Telly-S/Multiphase-Buck-Boost-Power-Supply/poster.png

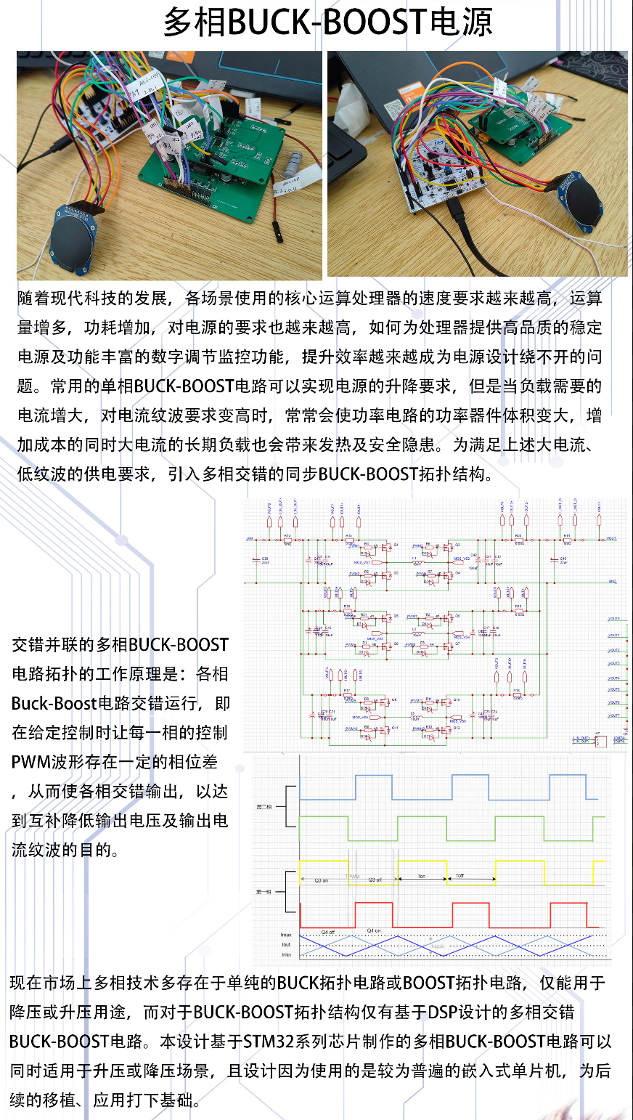
poster.png
