Telly-S/Multiphase-Buck-Boost-Power-Supply/README.md

2023 ST-嵌入式大赛 多相Buck-Boost电源
---

## 简介
本作品设计以 STM32G474 为主控芯片，本作品设计输出电源的范围为 0~30V 可调，在外接直流电源提供基础供能下，可以把任意范围内的输入电压转化为想要的输出电压，且由于电路的整流作用和闭环设计，使得输出的电源稳定、整洁。[介绍视频](https://www.alipan.com/s/BqMXYns31si)

## 介绍海报：
(https://postimg.cc/QVMbn3c7)

详细内容参见所附论文《多相Buck-Boost电源》

## 技术要点

| 功能 | 实现 | 说明 |
|:---|:---|:-----|
| 升降压 | 基于HRTIM的PWM | 信号成对出现，波形互补。信号切换时需要有死区的保护。 |
| 电流电压反馈 | adc | 多路adc监测输入输出时各通道的电流电压情况|
| 电压电流调节 | pid调控 | 主循环周期性调控 |
| 目标电压设定 | usart | 串口中断接收上位机指令 |
| 屏幕显示 | spi+lvgl | 定期刷新屏幕数据 |
