Telly-S/Multiphase-Buck-Boost-Power-Supply/Core/Src/main.c

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
/* Includes ------------------------------------------------------------------*/
#include "main.h"
#include "adc.h"
#include "hrtim.h"
#include "usart.h"
#include "spi.h"
#include "tim.h"
#include "gpio.h"

/* USER CODE BEGIN Includes */
#include "buck-boost.h"
#include "usmart.h"
#include "display.h"
#include "display_test.h"
#include "lvgl.h"
#include "display_conf.h"
#include "lv_port_disp_template.h"
#include "showAD.h"
/* USER CODE END Includes */


/* USER CODE BEGIN PV */
float ADval;
//float overall_out_u_fact, overall_in_u;  // 总输入输出电压(ADC实测值)
//float overall_out_u_target;  // 目标输出电压
RunMode_t runMode = noMode;
/* USER CODE END PV */

void SystemClock_Config(void);
/* USER CODE BEGIN 0 */
void changeModeFunc(void)
{
  if(v_out_target + delta_v < v_in)
  {
    //printf("enter buck \r\n");
    // 同步Buck模式
    switch(runMode)
    {
      case noMode:break;
      case SynchronizeBuckMode: /*synchronization_buck_mode(exitMode);*/ break;
      case IncreaseBuckboostMode: increase_buckboost_mode(exitMode); break;
      case DecreaseBuckboostMode: decrease_buckboost_mode(exitMode); break;
      case SynchronizeBoostMode: synchronization_boost_mode(exitMode); break;
    }

    if(runMode != SynchronizeBuckMode)
      synchronization_buck_mode(enterMode);

    runMode = SynchronizeBuckMode;
    synchronization_buck_mode(executeMode);
  }
  else if(v_out_target <= v_in && v_in <= v_out_target + delta_v)
  {
    //printf("enter reduce buck-boost\r\n");
    // 降压Buck Boost模式
    switch(runMode)
    {
      case noMode:break;
      case SynchronizeBuckMode: synchronization_buck_mode(exitMode); break;
      case IncreaseBuckboostMode: increase_buckboost_mode(exitMode); break;
      case DecreaseBuckboostMode: /*decrease_buckboost_mode(exitMode);*/ break;
      case SynchronizeBoostMode: synchronization_boost_mode(exitMode); break;
    }

    if(runMode != DecreaseBuckboostMode)
      decrease_buckboost_mode(enterMode);

    runMode = DecreaseBuckboostMode;
    decrease_buckboost_mode(executeMode);  // execute mode
  }
  else if(v_in < v_out_target && v_out_target <= v_in + delta_v)
  {
    // 升压Buck Boost模式
    //printf("enter incrase buck-boost\r\n");
    switch(runMode)
    {
      case noMode:break;
      case SynchronizeBuckMode: synchronization_buck_mode(exitMode); break;
      case IncreaseBuckboostMode: /*increase_buckboost_mode(exitMode);*/ break;
      case DecreaseBuckboostMode: decrease_buckboost_mode(exitMode); break;
      case SynchronizeBoostMode: synchronization_boost_mode(exitMode); break;
    }

    if(runMode != IncreaseBuckboostMode)
      increase_buckboost_mode(enterMode);

    runMode = IncreaseBuckboostMode;
    increase_buckboost_mode(executeMode);
  }
  else if(v_in + delta_v < v_out_target)
  {
    // 同步Boost模式
//    printf("enter boost \r\n");
    switch(runMode)
    {
      case noMode:break;
      case SynchronizeBuckMode: synchronization_buck_mode(exitMode); break;
      case IncreaseBuckboostMode: increase_buckboost_mode(exitMode); break;
      case DecreaseBuckboostMode: decrease_buckboost_mode(exitMode); break;
      case SynchronizeBoostMode: /*synchronization_boost_mode(exitMode);*/ break;
    }

    if(runMode != SynchronizeBoostMode)
      synchronization_boost_mode(enterMode);

    runMode = SynchronizeBoostMode;
    synchronization_boost_mode(executeMode);
  }
}
/* USER CODE END 0 */

/**
  * @brief  The application entry point.
  * @retval int
  */
int main(void)
{
  /* MCU Configuration--------------------------------------------------------*/

  /* Reset of all peripherals, Initializes the Flash interface and the Systick. */
  HAL_Init();

  /* Configure the system clock */
  SystemClock_Config();

  /* Initialize all configured peripherals */
  MX_GPIO_Init();
  MX_ADC1_Init();
  MX_ADC2_Init();
  MX_HRTIM1_Init();
  MX_LPUART1_UART_Init();
  MX_SPI3_Init();
  MX_TIM3_Init();
  /* USER CODE BEGIN 2 */
  HAL_TIM_Base_Start_IT(&htim3);
  lv_init();
	lv_port_disp_init();
	AD_label_event_init();
  
  HAL_HRTIM_WaveformOutputStart(&hhrtim1, HRTIM_TIMERID_MASTER);  // 开启主时钟同步
  HAL_HRTIM_WaveformCountStart(&hhrtim1, HRTIM_TIMERID_MASTER);
  
  // HAL_HRTIM_WaveformOutputStart(&hhrtim1, HRTIM_OUTPUT_TA1 | HRTIM_OUTPUT_TA2);
  // HAL_HRTIM_WaveformCountStart(&hhrtim1, HRTIM_TIMERID_TIMER_A);
  // HAL_HRTIM_WaveformOutputStart(&hhrtim1, HRTIM_OUTPUT_TB1 | HRTIM_OUTPUT_TB2);
  // HAL_HRTIM_WaveformCountStart(&hhrtim1, HRTIM_TIMERID_TIMER_B);
  HAL_HRTIM_WaveformOutputStart(&hhrtim1, HRTIM_OUTPUT_TC1 | HRTIM_OUTPUT_TC2);
  HAL_HRTIM_WaveformCountStart(&hhrtim1, HRTIM_TIMERID_TIMER_C);
  HAL_HRTIM_WaveformOutputStart(&hhrtim1, HRTIM_OUTPUT_TD1 | HRTIM_OUTPUT_TD2);
  HAL_HRTIM_WaveformCountStart(&hhrtim1, HRTIM_TIMERID_TIMER_D);
  HAL_HRTIM_WaveformOutputStart(&hhrtim1, HRTIM_OUTPUT_TE1 | HRTIM_OUTPUT_TE2);
  HAL_HRTIM_WaveformCountStart(&hhrtim1, HRTIM_TIMERID_TIMER_E);
  HAL_HRTIM_WaveformOutputStart(&hhrtim1, HRTIM_OUTPUT_TF1 | HRTIM_OUTPUT_TF2);
  HAL_HRTIM_WaveformCountStart(&hhrtim1, HRTIM_TIMERID_TIMER_F);
  /* USER CODE END 2 */

  /* Infinite loop */
  /* USER CODE BEGIN WHILE */
  // __HAL_HRTIM_SETCOMPARE(&hhrtim1, 0x0, HRTIM_COMPAREUNIT_1, 0);  // 0x0 to 0x5 for timers A to F
  // __HAL_HRTIM_SETCOMPARE(&hhrtim1, 0x1, HRTIM_COMPAREUNIT_1, 0);  // PWM set zero
  __HAL_HRTIM_SETCOMPARE(&hhrtim1, 0x2, HRTIM_COMPAREUNIT_1, 0);
  __HAL_HRTIM_SETCOMPARE(&hhrtim1, 0x3, HRTIM_COMPAREUNIT_1, 0);
  __HAL_HRTIM_SETCOMPARE(&hhrtim1, 0x4, HRTIM_COMPAREUNIT_1, 0);
  __HAL_HRTIM_SETCOMPARE(&hhrtim1, 0x5, HRTIM_COMPAREUNIT_1, 0);
  
  usmart_dev.init(0);		//初始化USMART
  config_param_init();  // 预设参数初始化
  v_out_target = 1.8;  // 这个考虑定时器中断进行修改
  while (1)
  {
    change_AD_data(0, 11.0);
    // v_in 是否需要做成动态采集    
    v_in = Get_Adc_MidValue(overall_in.adcx_ptr, overall_in.ADC_Channel);
    printf("v_in: %f\r\n", v_in);
    
    if(v_in > 0.9f)  // 必须要有一定的输入电压
      changeModeFunc();
    else
      printf("v_in is too low to run\r\n");
    
    HAL_Delay(120);  // TODO 时间暂时调大，便于调试

    HAL_GPIO_TogglePin(LD2_GPIO_Port, LD2_Pin);
    
    usmart_dev.scan(); // 执行usmart扫描
    lv_timer_handler();
    
    printf("draw: %f,%f,%f\r\n", v_out_target, Get_Adc_MidValue(overall_out.adcx_ptr, overall_out.ADC_Channel),
                                    Get_Adc_MidValue(overall_in.adcx_ptr, overall_in.ADC_Channel)
                                    );
    /* USER CODE END WHILE */

    /* USER CODE BEGIN 3 */
  }
  /* USER CODE END 3 */
}

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
