Telly-S/Multiphase-Buck-Boost-Power-Supply/Core/Inc/main.h

#define B1_Pin GPIO_PIN_13
#define B1_GPIO_Port GPIOC
#define LPUART1_TX_Pin GPIO_PIN_2
#define LPUART1_TX_GPIO_Port GPIOA
#define LPUART1_RX_Pin GPIO_PIN_3
#define LPUART1_RX_GPIO_Port GPIOA
#define LD2_Pin GPIO_PIN_5
#define LD2_GPIO_Port GPIOA
#define T_SWDIO_Pin GPIO_PIN_13
#define T_SWDIO_GPIO_Port GPIOA
#define T_SWCLK_Pin GPIO_PIN_14
#define T_SWCLK_GPIO_Port GPIOA
#define T_SWO_Pin GPIO_PIN_3
#define T_SWO_GPIO_Port GPIOB
#define SCLK_Pin		GPIO_PIN_10
#define SCLK_GPIO_Port	GPIOC
#define MOSI_Pin 		GPIO_PIN_12
#define MOSI_GPIO_Port 	GPIOC
#define DC_Pin 		GPIO_PIN_7
#define DC_GPIO_Port	GPIOB
#define RES_Pin GPIO_PIN_6
#define RES_GPIO_Port GPIOB
#define CS_Pin GPIO_PIN_5
#define CS_GPIO_Port GPIOB
