Telly-S/Multiphase-Buck-Boost-Power-Supply/Core/Src/adc.c

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
/* Includes ------------------------------------------------------------------*/
#include "adc.h"

/* USER CODE BEGIN 0 */
#include <stdio.h>
/* USER CODE END 0 */

ADC_HandleTypeDef hadc1;
ADC_HandleTypeDef hadc2;

/* ADC1 init function */
void MX_ADC1_Init(void)
{

  ADC_MultiModeTypeDef multimode = {0};
  ADC_ChannelConfTypeDef sConfig = {0};

  /** Common config
  */
  hadc1.Instance = ADC1;
  hadc1.Init.ClockPrescaler = ADC_CLOCK_SYNC_PCLK_DIV4;
  hadc1.Init.Resolution = ADC_RESOLUTION_12B;
  hadc1.Init.DataAlign = ADC_DATAALIGN_RIGHT;
  hadc1.Init.GainCompensation = 0;
  hadc1.Init.ScanConvMode = ADC_SCAN_DISABLE;
  hadc1.Init.EOCSelection = ADC_EOC_SINGLE_CONV;
  hadc1.Init.LowPowerAutoWait = DISABLE;
  hadc1.Init.ContinuousConvMode = DISABLE;
  hadc1.Init.NbrOfConversion = 1;
  hadc1.Init.DiscontinuousConvMode = DISABLE;
  hadc1.Init.ExternalTrigConv = ADC_SOFTWARE_START;
  hadc1.Init.ExternalTrigConvEdge = ADC_EXTERNALTRIGCONVEDGE_NONE;
  hadc1.Init.DMAContinuousRequests = DISABLE;
  hadc1.Init.Overrun = ADC_OVR_DATA_PRESERVED;
  hadc1.Init.OversamplingMode = DISABLE;
  if (HAL_ADC_Init(&hadc1) != HAL_OK)
  {
    Error_Handler();
  }

  /** Configure the ADC multi-mode
  */
  multimode.Mode = ADC_MODE_INDEPENDENT;
  if (HAL_ADCEx_MultiModeConfigChannel(&hadc1, &multimode) != HAL_OK)
  {
    Error_Handler();
  }

  /** Configure Regular Channel
  */
  sConfig.Channel = ADC_CHANNEL_1;
  sConfig.Rank = ADC_REGULAR_RANK_1;
  sConfig.SamplingTime = ADC_SAMPLETIME_640CYCLES_5;
  sConfig.SingleDiff = ADC_SINGLE_ENDED;
  sConfig.OffsetNumber = ADC_OFFSET_NONE;
  sConfig.Offset = 0;
  if (HAL_ADC_ConfigChannel(&hadc1, &sConfig) != HAL_OK)
  {
    Error_Handler();
  }
}
/* ADC2 init function */
void MX_ADC2_Init(void)
{

  ADC_ChannelConfTypeDef sConfig = {0};

  /** Common config
  */
  hadc2.Instance = ADC2;
  hadc2.Init.ClockPrescaler = ADC_CLOCK_SYNC_PCLK_DIV4;
  hadc2.Init.Resolution = ADC_RESOLUTION_12B;
  hadc2.Init.DataAlign = ADC_DATAALIGN_RIGHT;
  hadc2.Init.GainCompensation = 0;
  hadc2.Init.ScanConvMode = ADC_SCAN_DISABLE;
  hadc2.Init.EOCSelection = ADC_EOC_SINGLE_CONV;
  hadc2.Init.LowPowerAutoWait = DISABLE;
  hadc2.Init.ContinuousConvMode = DISABLE;
  hadc2.Init.NbrOfConversion = 1;
  hadc2.Init.DiscontinuousConvMode = DISABLE;
  hadc2.Init.ExternalTrigConv = ADC_SOFTWARE_START;
  hadc2.Init.ExternalTrigConvEdge = ADC_EXTERNALTRIGCONVEDGE_NONE;
  hadc2.Init.DMAContinuousRequests = DISABLE;
  hadc2.Init.Overrun = ADC_OVR_DATA_PRESERVED;
  hadc2.Init.OversamplingMode = DISABLE;
  if (HAL_ADC_Init(&hadc2) != HAL_OK)
  {
    Error_Handler();
  }

  /** Configure Regular Channel
  */
  sConfig.Channel = ADC_CHANNEL_3;
  sConfig.Rank = ADC_REGULAR_RANK_1;
  sConfig.SamplingTime = ADC_SAMPLETIME_640CYCLES_5;
  sConfig.SingleDiff = ADC_SINGLE_ENDED;
  sConfig.OffsetNumber = ADC_OFFSET_NONE;
  sConfig.Offset = 0;
  if (HAL_ADC_ConfigChannel(&hadc2, &sConfig) != HAL_OK)
  {
    Error_Handler();
  }
}

static uint32_t HAL_RCC_ADC12_CLK_ENABLED=0;

void HAL_ADC_MspInit(ADC_HandleTypeDef* adcHandle)
{

  GPIO_InitTypeDef GPIO_InitStruct = {0};
  RCC_PeriphCLKInitTypeDef PeriphClkInit = {0};
  if(adcHandle->Instance==ADC1)
  {
  /** Initializes the peripherals clocks
  */
    PeriphClkInit.PeriphClockSelection = RCC_PERIPHCLK_ADC12;
    PeriphClkInit.Adc12ClockSelection = RCC_ADC12CLKSOURCE_SYSCLK;
    if (HAL_RCCEx_PeriphCLKConfig(&PeriphClkInit) != HAL_OK)
    {
      Error_Handler();
    }

    /* ADC1 clock enable */
    HAL_RCC_ADC12_CLK_ENABLED++;
    if(HAL_RCC_ADC12_CLK_ENABLED==1){
      __HAL_RCC_ADC12_CLK_ENABLE();
    }

    __HAL_RCC_GPIOC_CLK_ENABLE();
    __HAL_RCC_GPIOA_CLK_ENABLE();
    __HAL_RCC_GPIOB_CLK_ENABLE();
    /**ADC1 GPIO Configuration
    PC0     ------> ADC1_IN6
    PC1     ------> ADC1_IN7
    PC2     ------> ADC1_IN8
    PC3     ------> ADC1_IN9
    PA0     ------> ADC1_IN1
    PA1     ------> ADC1_IN2
    PB1     ------> ADC1_IN12
    PB11     ------> ADC1_IN14
    */
    GPIO_InitStruct.Pin = GPIO_PIN_0|GPIO_PIN_1|GPIO_PIN_2|GPIO_PIN_3;
    GPIO_InitStruct.Mode = GPIO_MODE_ANALOG;
    GPIO_InitStruct.Pull = GPIO_NOPULL;
    HAL_GPIO_Init(GPIOC, &GPIO_InitStruct);

    GPIO_InitStruct.Pin = GPIO_PIN_0|GPIO_PIN_1;
    GPIO_InitStruct.Mode = GPIO_MODE_ANALOG;
    GPIO_InitStruct.Pull = GPIO_NOPULL;
    HAL_GPIO_Init(GPIOA, &GPIO_InitStruct);

    GPIO_InitStruct.Pin = GPIO_PIN_1|GPIO_PIN_11;
    GPIO_InitStruct.Mode = GPIO_MODE_ANALOG;
    GPIO_InitStruct.Pull = GPIO_NOPULL;
    HAL_GPIO_Init(GPIOB, &GPIO_InitStruct);

  }
  else if(adcHandle->Instance==ADC2)
  {
  /** Initializes the peripherals clocks
  */
    PeriphClkInit.PeriphClockSelection = RCC_PERIPHCLK_ADC12;
    PeriphClkInit.Adc12ClockSelection = RCC_ADC12CLKSOURCE_SYSCLK;
    if (HAL_RCCEx_PeriphCLKConfig(&PeriphClkInit) != HAL_OK)
    {
      Error_Handler();
    }

    /* ADC2 clock enable */
    HAL_RCC_ADC12_CLK_ENABLED++;
    if(HAL_RCC_ADC12_CLK_ENABLED==1){
      __HAL_RCC_ADC12_CLK_ENABLE();
    }

    __HAL_RCC_GPIOA_CLK_ENABLE();
    __HAL_RCC_GPIOC_CLK_ENABLE();
    __HAL_RCC_GPIOB_CLK_ENABLE();
    /**ADC2 GPIO Configuration
    PA4     ------> ADC2_IN17
    PA6     ------> ADC2_IN3
    PA7     ------> ADC2_IN4
    PC4     ------> ADC2_IN5
    PC5     ------> ADC2_IN11
    PB2     ------> ADC2_IN12
    */
    GPIO_InitStruct.Pin = GPIO_PIN_4|GPIO_PIN_6|GPIO_PIN_7;
    GPIO_InitStruct.Mode = GPIO_MODE_ANALOG;
    GPIO_InitStruct.Pull = GPIO_NOPULL;
    HAL_GPIO_Init(GPIOA, &GPIO_InitStruct);

    GPIO_InitStruct.Pin = GPIO_PIN_4|GPIO_PIN_5;
    GPIO_InitStruct.Mode = GPIO_MODE_ANALOG;
    GPIO_InitStruct.Pull = GPIO_NOPULL;
    HAL_GPIO_Init(GPIOC, &GPIO_InitStruct);

    GPIO_InitStruct.Pin = GPIO_PIN_2;
    GPIO_InitStruct.Mode = GPIO_MODE_ANALOG;
    GPIO_InitStruct.Pull = GPIO_NOPULL;
    HAL_GPIO_Init(GPIOB, &GPIO_InitStruct);

  }
}

void HAL_ADC_MspDeInit(ADC_HandleTypeDef* adcHandle)
{

  if(adcHandle->Instance==ADC1)
  {
    /* Peripheral clock disable */
    HAL_RCC_ADC12_CLK_ENABLED--;
    if(HAL_RCC_ADC12_CLK_ENABLED==0){
      __HAL_RCC_ADC12_CLK_DISABLE();
    }

    /**ADC1 GPIO Configuration
    PC0     ------> ADC1_IN6
    PC1     ------> ADC1_IN7
    PC2     ------> ADC1_IN8
    PC3     ------> ADC1_IN9
    PA0     ------> ADC1_IN1
    PA1     ------> ADC1_IN2
    PB1     ------> ADC1_IN12
    PB11     ------> ADC1_IN14
    */
    HAL_GPIO_DeInit(GPIOC, GPIO_PIN_0|GPIO_PIN_1|GPIO_PIN_2|GPIO_PIN_3);

    HAL_GPIO_DeInit(GPIOA, GPIO_PIN_0|GPIO_PIN_1);

    HAL_GPIO_DeInit(GPIOB, GPIO_PIN_1|GPIO_PIN_11);

  }
  else if(adcHandle->Instance==ADC2)
  {
    /* Peripheral clock disable */
    HAL_RCC_ADC12_CLK_ENABLED--;
    if(HAL_RCC_ADC12_CLK_ENABLED==0){
      __HAL_RCC_ADC12_CLK_DISABLE();
    }

    /**ADC2 GPIO Configuration
    PA4     ------> ADC2_IN17
    PA6     ------> ADC2_IN3
    PA7     ------> ADC2_IN4
    PC4     ------> ADC2_IN5
    PC5     ------> ADC2_IN11
    PB2     ------> ADC2_IN12
    */
    HAL_GPIO_DeInit(GPIOA, GPIO_PIN_4|GPIO_PIN_6|GPIO_PIN_7);

    HAL_GPIO_DeInit(GPIOC, GPIO_PIN_4|GPIO_PIN_5);

    HAL_GPIO_DeInit(GPIOB, GPIO_PIN_2);

  }
}

/* USER CODE BEGIN 1 */

adc_gather  phase1out_u = {&hadc1, ADC_CHANNEL_1}, 
            phase1out_i = {&hadc1, ADC_CHANNEL_2},
            phase2out_u = {&hadc1, ADC_CHANNEL_6}, 
            phase2out_i = {&hadc1, ADC_CHANNEL_7}, 
            phase3out_u = {&hadc1, ADC_CHANNEL_8}, 
            phase3out_i = {&hadc1, ADC_CHANNEL_9},
            phase1in_u  = {&hadc1, ADC_CHANNEL_12},
            phase1in_i  = {&hadc1, ADC_CHANNEL_14},
            phase2in_u  = {&hadc2, ADC_CHANNEL_3},
            phase2in_i  = {&hadc2, ADC_CHANNEL_4},
            phase3in_u  = {&hadc2, ADC_CHANNEL_5},
            phase3in_i  = {&hadc2, ADC_CHANNEL_11},
            overall_out = {&hadc2, ADC_CHANNEL_12},
            overall_in  = {&hadc2, ADC_CHANNEL_17};

//获得 ADC 值
//ch: 通道值 0~16，取值范围为：ADC_CHANNEL_0~ADC_CHANNEL_16
//返回值:转换结果
uint32_t Get_Adc(ADC_HandleTypeDef * hadc_ptr, uint32_t ch)
{
  ADC_ChannelConfTypeDef sConfig = {0};
  sConfig.Channel = ch;
  sConfig.Rank = ADC_REGULAR_RANK_1;
  sConfig.SamplingTime = ADC_SAMPLETIME_640CYCLES_5;
  sConfig.SingleDiff = ADC_SINGLE_ENDED;
  sConfig.OffsetNumber = ADC_OFFSET_NONE;
  sConfig.Offset = 0;
  if (HAL_ADC_ConfigChannel(hadc_ptr, &sConfig) != HAL_OK)
  {
    Error_Handler();
  }
  
  HAL_ADCEx_Calibration_Start(hadc_ptr, ADC_SINGLE_ENDED);
  
  HAL_ADC_Start(hadc_ptr);                      //开启 AD
  HAL_ADC_PollForConversion(hadc_ptr, 10);      //轮询转换
  return (uint32_t)HAL_ADC_GetValue(hadc_ptr);  //返回最近转换结果
}

/**
 * @brief 获取指定通道的电压值
 * 
 * @param hadc_ptr : adcx_ptr
 * @param ch       : 通道
 * @param times    : 均衡次数
 * @return float   : 电压值
 */
float Get_Adc_Average(ADC_HandleTypeDef * hadc_ptr, uint32_t ch, uint8_t times)
{
  uint32_t temp_val=0;
  uint8_t t;
  for(t=0; t<times; t++)
  {
    temp_val += Get_Adc(hadc_ptr, ch);
    HAL_Delay(1);
  }
  return (float)(((temp_val/times)*(3.3/4095))*10.0);
}

/**
 * @brief 获取指定通道的电压值（中值滤波）
 * 
 * @param hadc_ptr : adcx_ptr
 * @param ch       : 通道
 * @return float   : 电压值
 */
float Get_Adc_MidValue(ADC_HandleTypeDef * hadc_ptr, uint32_t ch)
{
  const uint8_t arrayLen = 20;
  float v_in_array[arrayLen] = {0};
  for(uint8_t i = 0; i < arrayLen; i++)
      v_in_array[i] = Get_Adc_Average(hadc_ptr, ch, 1);
  
  float temp = 0.0f;
  for(uint8_t i = 0; i < arrayLen-1; i++)
  {
    for(uint8_t j = 0; j < arrayLen-1-i; j++)
    {
      if(v_in_array[j] > v_in_array[j+1])
      {
        temp = v_in_array[j];
        v_in_array[j] = v_in_array[j+1];
        v_in_array[j+1] = temp;
      }
    }
  }
//  for(uint8_t i = 0; i < arrayLen; i++) 
//      printf("%.2f ", v_in_array[i]);
//    printf("\r\n");
  
  return v_in_array[6];
}

/* USER CODE END 1 */
