Telly-S/Multiphase-Buck-Boost-Power-Supply/Core/Src/usart.c

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
/* Includes ------------------------------------------------------------------*/
#include "usart.h"

/* USER CODE BEGIN 0 */
// 串口1中断服务程序
// 注意,读取USARTx->SR能避免莫名其妙的错误
uint8_t USART_RX_BUF[USART_REC_LEN]; // 接收缓冲,最大USART_REC_LEN个字节.
// 接收状态
// bit15，	接收完成标志
// bit14，	接收到0x0d
// bit13~0，	接收到的有效字节数目
uint16_t USART_RX_STA = 0; // 接收状态标记

uint8_t aRxBuffer[RXBUFFERSIZE]; // HAL库使用的串口接收缓冲

// 接收回调函数
void HAL_UART_RxCpltCallback(UART_HandleTypeDef *huart)
{
  if (huart->Instance == LPUART1) // 如果是P串口1
  {
    if ((USART_RX_STA & 0x8000) == 0) // 接收未完成
    {
      if (USART_RX_STA & 0x4000) // 接收到了0x0d
      {
        if (aRxBuffer[0] != 0x0a)
          USART_RX_STA = 0; // 接收错误,重新开始
        else
          USART_RX_STA |= 0x8000; // 接收完成了
      }
      else // 还没收到0X0D
      {
        if (aRxBuffer[0] == 0x0d)
          USART_RX_STA |= 0x4000;
        else
        {
          USART_RX_BUF[USART_RX_STA & 0X3FFF] = aRxBuffer[0];
          USART_RX_STA++;
          if (USART_RX_STA > (USART_REC_LEN - 1))
            USART_RX_STA = 0; // 接收数据错误,重新开始接收
        }
      }
    }
    HAL_UART_Receive_IT(&hlpuart1, (uint8_t *)aRxBuffer, RXBUFFERSIZE); // 开启下一次接收中断
  }
}
/* USER CODE END 0 */

UART_HandleTypeDef hlpuart1;

/* LPUART1 init function */

void MX_LPUART1_UART_Init(void)
{

  hlpuart1.Instance = LPUART1;
  hlpuart1.Init.BaudRate = 115200;
  hlpuart1.Init.WordLength = UART_WORDLENGTH_8B;
  hlpuart1.Init.StopBits = UART_STOPBITS_1;
  hlpuart1.Init.Parity = UART_PARITY_NONE;
  hlpuart1.Init.Mode = UART_MODE_TX_RX;
  hlpuart1.Init.HwFlowCtl = UART_HWCONTROL_NONE;
  hlpuart1.Init.OneBitSampling = UART_ONE_BIT_SAMPLE_DISABLE;
  hlpuart1.Init.ClockPrescaler = UART_PRESCALER_DIV1;
  hlpuart1.AdvancedInit.AdvFeatureInit = UART_ADVFEATURE_NO_INIT;
  if (HAL_UART_Init(&hlpuart1) != HAL_OK)
  {
    Error_Handler();
  }
  if (HAL_UARTEx_SetTxFifoThreshold(&hlpuart1, UART_TXFIFO_THRESHOLD_1_8) != HAL_OK)
  {
    Error_Handler();
  }
  if (HAL_UARTEx_SetRxFifoThreshold(&hlpuart1, UART_RXFIFO_THRESHOLD_1_8) != HAL_OK)
  {
    Error_Handler();
  }
  if (HAL_UARTEx_DisableFifoMode(&hlpuart1) != HAL_OK)
  {
    Error_Handler();
  }
  /* USER CODE BEGIN LPUART1_Init 2 */
  // 这个需要放在 HAL_UART_Init() 之后
  // 该函数会开启接收中断：标志位UART_IT_RXNE，并且设置接收缓冲以及接收缓冲接收最大数据量
  HAL_UART_Receive_IT(&hlpuart1, (uint8_t *)aRxBuffer, RXBUFFERSIZE);
  /* USER CODE END LPUART1_Init 2 */

}

void HAL_UART_MspInit(UART_HandleTypeDef* uartHandle)
{

  GPIO_InitTypeDef GPIO_InitStruct = {0};
  RCC_PeriphCLKInitTypeDef PeriphClkInit = {0};
  if(uartHandle->Instance==LPUART1)
  {
  /** Initializes the peripherals clocks
  */
    PeriphClkInit.PeriphClockSelection = RCC_PERIPHCLK_LPUART1;
    PeriphClkInit.Lpuart1ClockSelection = RCC_LPUART1CLKSOURCE_PCLK1;
    if (HAL_RCCEx_PeriphCLKConfig(&PeriphClkInit) != HAL_OK)
    {
      Error_Handler();
    }

    /* LPUART1 clock enable */
    __HAL_RCC_LPUART1_CLK_ENABLE();

    __HAL_RCC_GPIOA_CLK_ENABLE();
    /**LPUART1 GPIO Configuration
    PA2     ------> LPUART1_TX
    PA3     ------> LPUART1_RX
    */
    GPIO_InitStruct.Pin = LPUART1_TX_Pin|LPUART1_RX_Pin;
    GPIO_InitStruct.Mode = GPIO_MODE_AF_PP;
    GPIO_InitStruct.Pull = GPIO_NOPULL;
    GPIO_InitStruct.Speed = GPIO_SPEED_FREQ_VERY_HIGH;
    GPIO_InitStruct.Alternate = GPIO_AF12_LPUART1;
    HAL_GPIO_Init(GPIOA, &GPIO_InitStruct);

    /* LPUART1 interrupt Init */
    HAL_NVIC_SetPriority(LPUART1_IRQn, 4, 0);
    HAL_NVIC_EnableIRQ(LPUART1_IRQn);
  }
}

void HAL_UART_MspDeInit(UART_HandleTypeDef* uartHandle)
{

  if(uartHandle->Instance==LPUART1)
  {
    /* Peripheral clock disable */
    __HAL_RCC_LPUART1_CLK_DISABLE();

    /**LPUART1 GPIO Configuration
    PA2     ------> LPUART1_TX
    PA3     ------> LPUART1_RX
    */
    HAL_GPIO_DeInit(GPIOA, LPUART1_TX_Pin|LPUART1_RX_Pin);

    /* LPUART1 interrupt Deinit */
    HAL_NVIC_DisableIRQ(LPUART1_IRQn);
  }
}

/* USER CODE BEGIN 1 */
int fputc(int ch, FILE *f)
{
  // 具体哪个串口可以更改huart1为其它串口
  HAL_UART_Transmit(&hlpuart1, (uint8_t *)&ch, 1, 0xff);
  return ch;
}
/* USER CODE END 1 */
