Telly-S/Multiphase-Buck-Boost-Power-Supply/(notices)

Notices in the files:
Core/Src/main.c:
Copyright (c) 2023 STMicroelectronics.
All rights reserved.
This software is licensed under terms that can be found in the LICENSE file
USMART/usmart.c:
Copyright(C) ÕýµãÔ­×Ó 2011-2021
